thekoenrutten/VixenSuperPolarisMotordrive/cad/step/housing_assembly.step

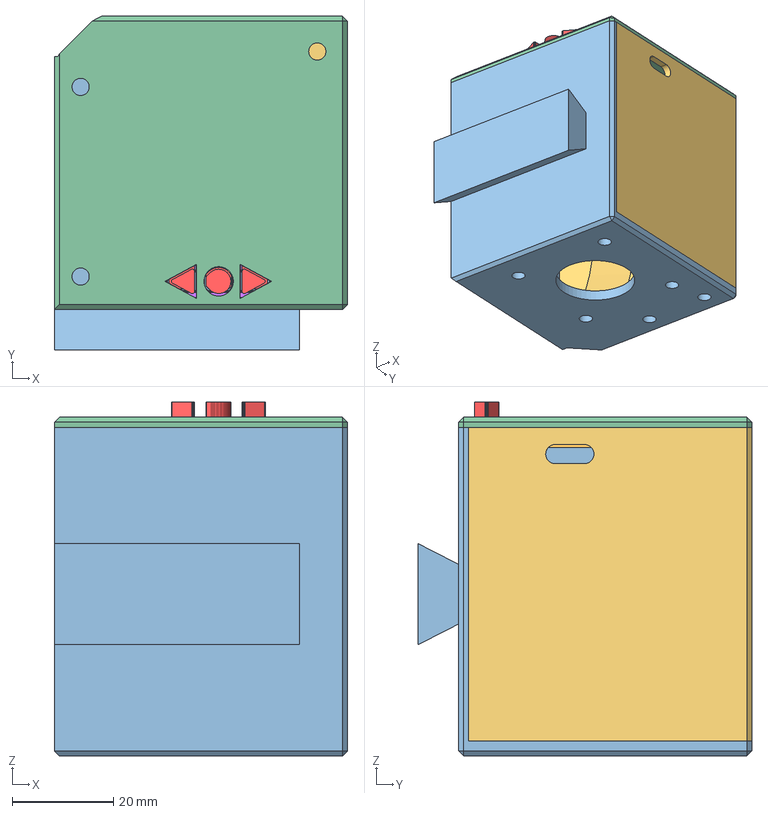
[picture p6: CAD file, 2026-11-03]
cad/step/housing_assembly.step
58.0 x 66.0 x 70.0 mm
chassis
back_plate
carrier
cap
push_pin_1
push_pin_2
push_pin_3
