thekoenrutten/VixenSuperPolarisMotordrive/cad/step/pulley_44T_bore13.3.step

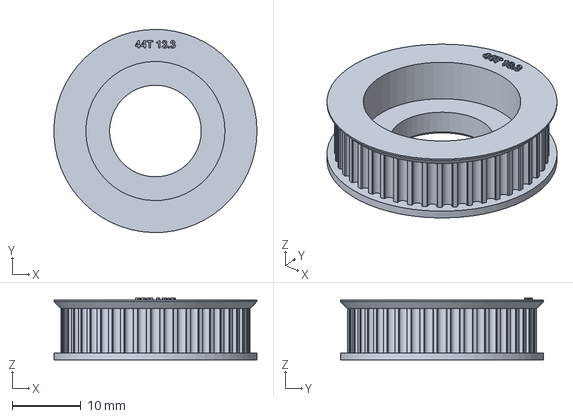
[picture p7: CAD file, 2026-11-03]
cad/step/pulley_44T_bore13.3.step
29.5 x 29.5 x 9.00 mm
