thekoenrutten/VixenSuperPolarisMotordrive/stl/back_plate.stl

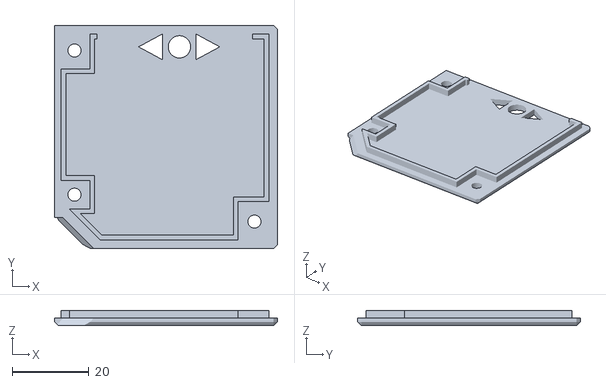
[picture p8: CAD file, 2026-11-03]
stl/back_plate.stl
58.0 x 58.0 x 4.00
