thekoenrutten/VixenSuperPolarisMotordrive/stl/pulley_bore_test_strip.stl

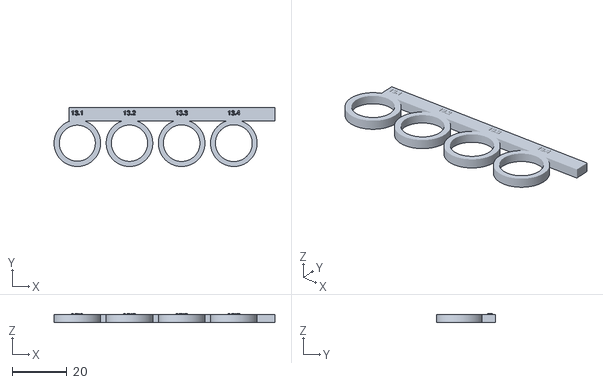
[picture p9: CAD file, 2026-11-03]
stl/pulley_bore_test_strip.stl
80.5 x 21.5 x 3.35
