thekoenrutten/VixenSuperPolarisMotordrive/stl/push_pin_3_right.stl

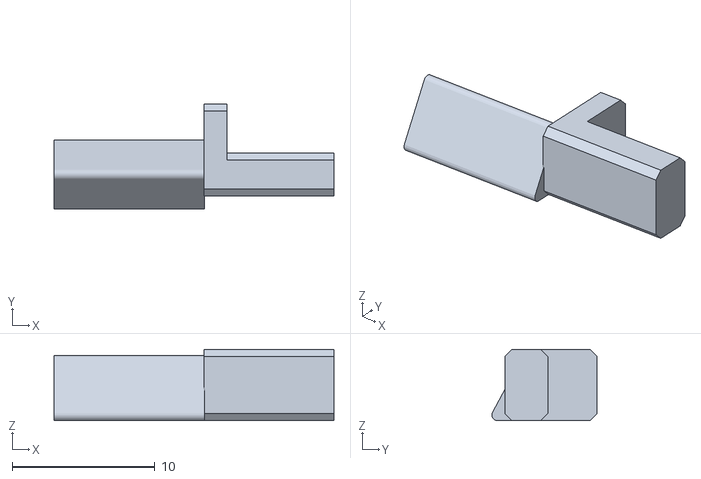
[picture p10: CAD file, 2026-11-03]
stl/push_pin_3_right.stl
19.6 x 7.38 x 5.00
