thekoenrutten/VixenSuperPolarisMotordrive/stl/pulley_44T_bore13.2.stl

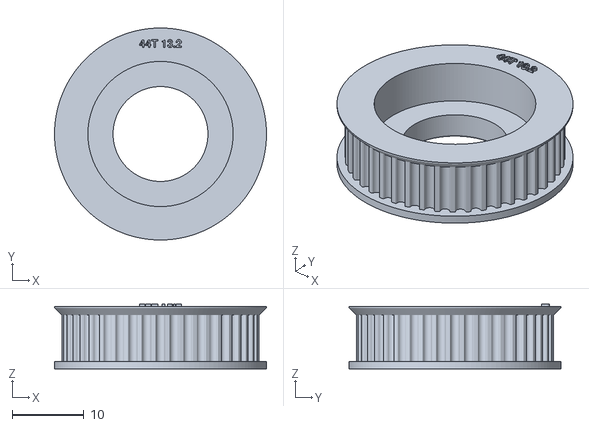
[picture p11: CAD file, 2026-11-03]
stl/pulley_44T_bore13.2.stl
29.5 x 29.5 x 9.00
