thekoenrutten/VixenSuperPolarisMotordrive/stl/shell.stl

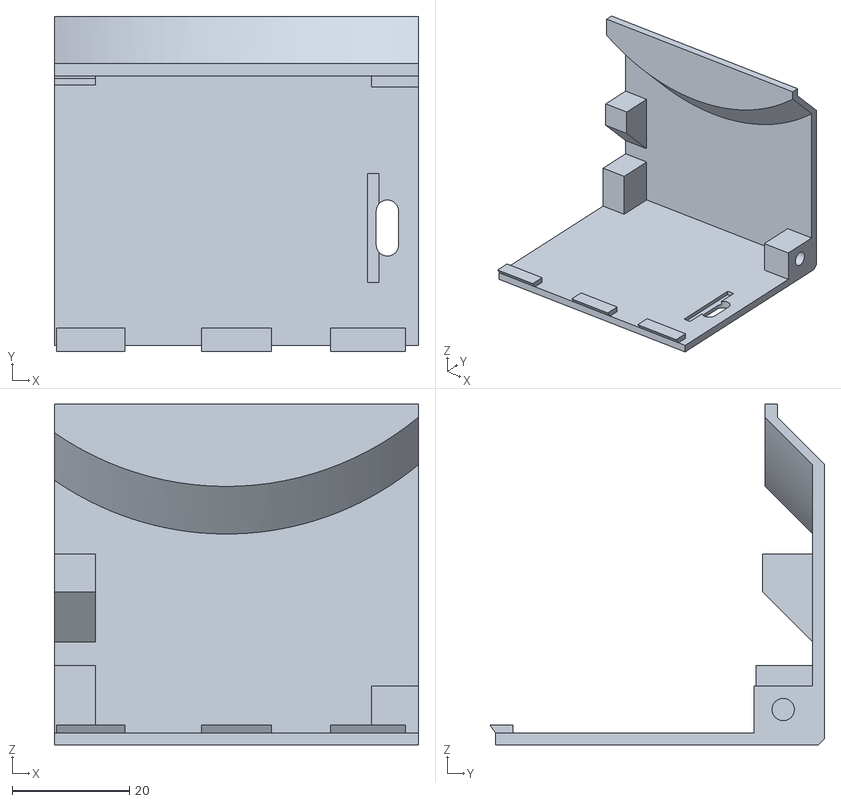
[picture p12: CAD file, 2026-11-03]
stl/shell.stl
62.0 x 57.0 x 58.0
