thekoenrutten/VixenSuperPolarisMotordrive/stl/chassis.stl

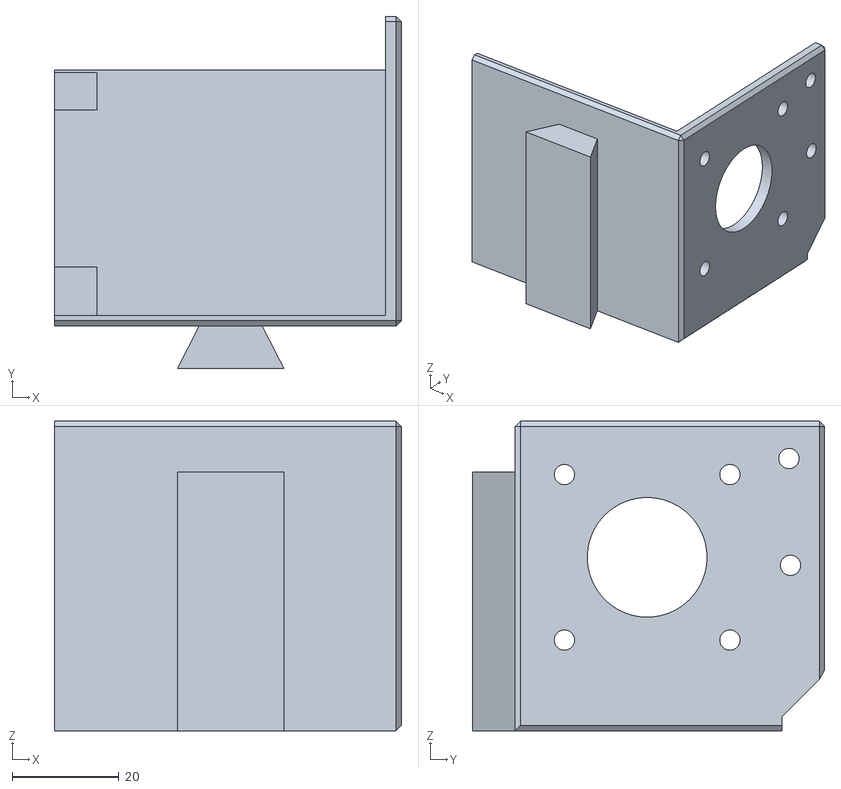
[picture p13: CAD file, 2026-11-03]
stl/chassis.stl
65.0 x 66.0 x 58.0
