thekoenrutten/VixenSuperPolarisMotordrive/stl/push_pins_x3.stl

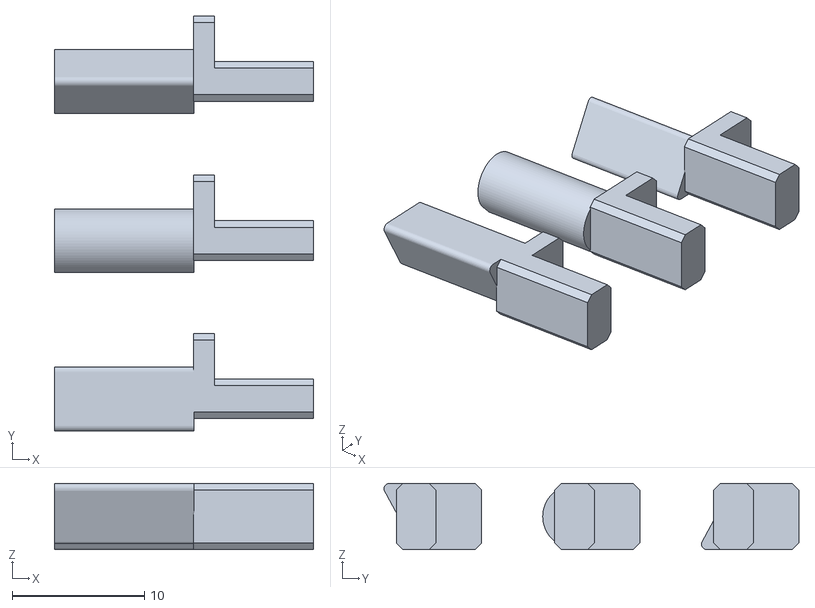
[picture p14: CAD file, 2026-11-03]
stl/push_pins_x3.stl
19.6 x 31.4 x 5.00
