thekoenrutten/VixenSuperPolarisMotordrive/stl/push_pin_2_round.stl

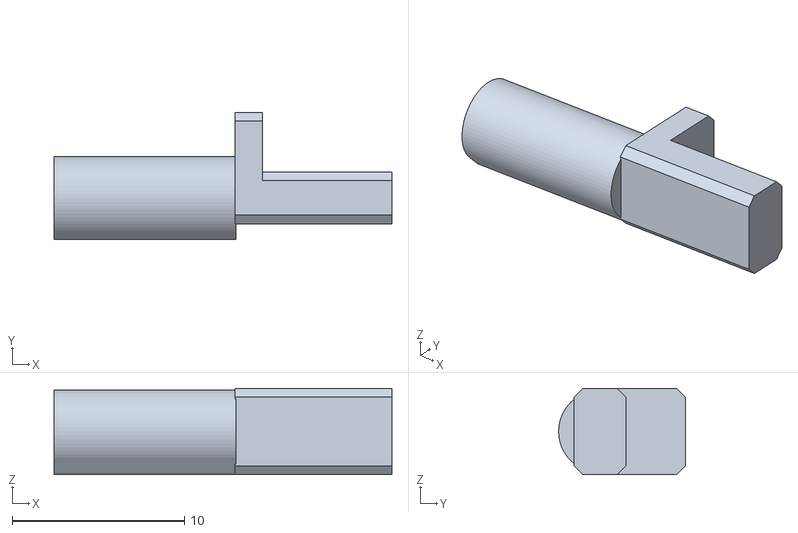
[picture p15: CAD file, 2026-11-03]
stl/push_pin_2_round.stl
19.6 x 7.35 x 5.00
