thekoenrutten/VixenSuperPolarisMotordrive/stl/cap.stl

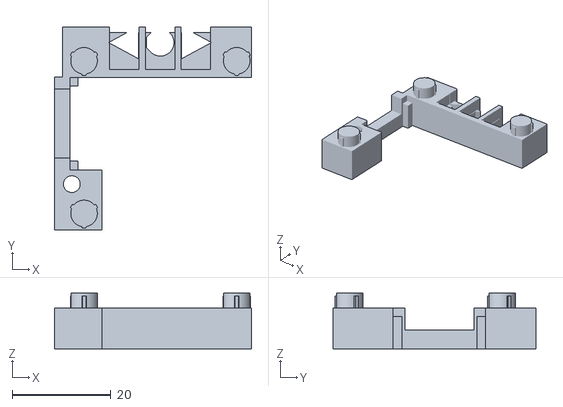
[picture p16: CAD file, 2026-11-03]
stl/cap.stl
40.0 x 41.2 x 11.3
