thekoenrutten/VixenSuperPolarisMotordrive/stl/carrier.stl

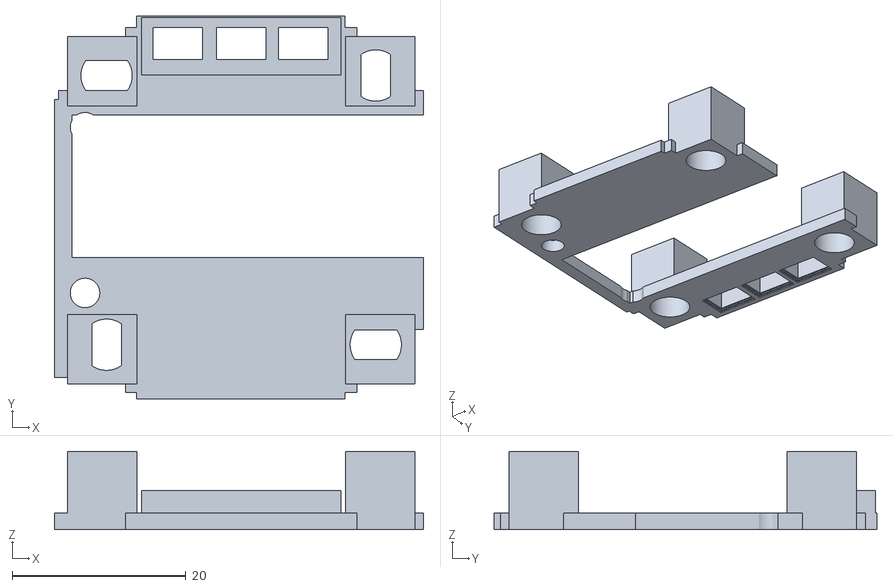
[picture p17: CAD file, 2026-11-03]
stl/carrier.stl
42.5 x 44.1 x 9.00
