thekoenrutten/VixenSuperPolarisMotordrive/(list of files, cad)

Other CAD files:
stl/push_pin_1_left.stl
stl/pulley_44T_bore13.3.stl
