thekoenrutten/VixenSuperPolarisMotordrive/(commit log)

2026-11-03 Vixen SP RA drive: final design P10i/P8d, firmware 3.2, docs
    Claude-Session: https://claude.ai/code/session_01XmicZ23Ma4KkLDjLehop6t
    [back_plate.stl, cap.stl, carrier.stl, chassis.stl, housing_assembly.step, pulley_44T_bore13.2.stl, pulley_44T_bore13.3.step, pulley_44T_bore13.3.stl]
2026-11-04 Add photos of the drive on the mount to the README
    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
2026-11-04 Add printed-parts overview and wiring diagram; document the P1 cable to the PD trigger
    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
